ArqueologiaDigital/Custom_TV_Games/README.md

# Custom_TV_Games

Materials for a study group focused on exploring the ideas described in the book "How To Design and Build You Own Custom TV Games" by David L. Heiserman (November, 1978).

* KICAD: Circuits from the book re-drawn on CAD software for experimental PCB manufacturing. These are adapted for being built nowadays (2018).
* LaTeX: A transcription of the book in LaTeX syntax.
