ArqueologiaDigital/Custom_TV_Games/LaTeX/images/fig2-4a.png

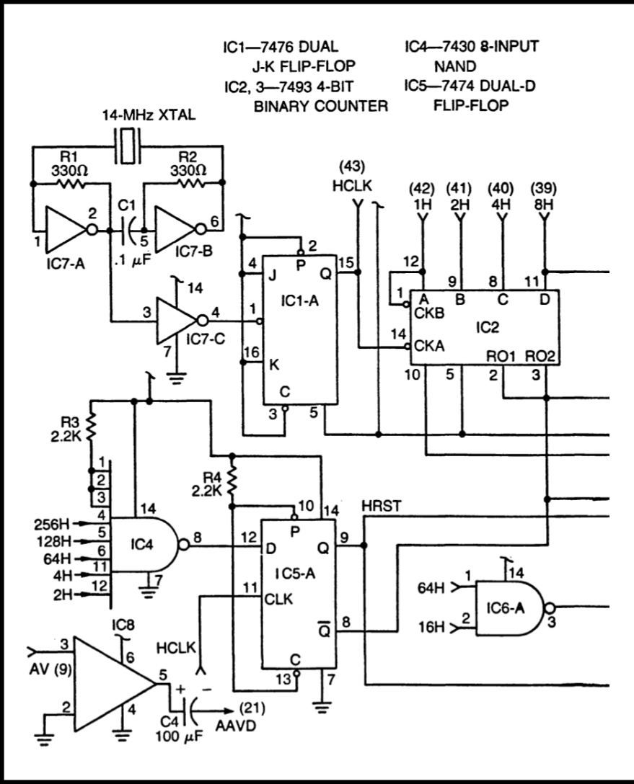
LaTeX/images/fig2-4a.png
