ArqueologiaDigital/Custom_TV_Games/LaTeX/images/fig2-4b.png

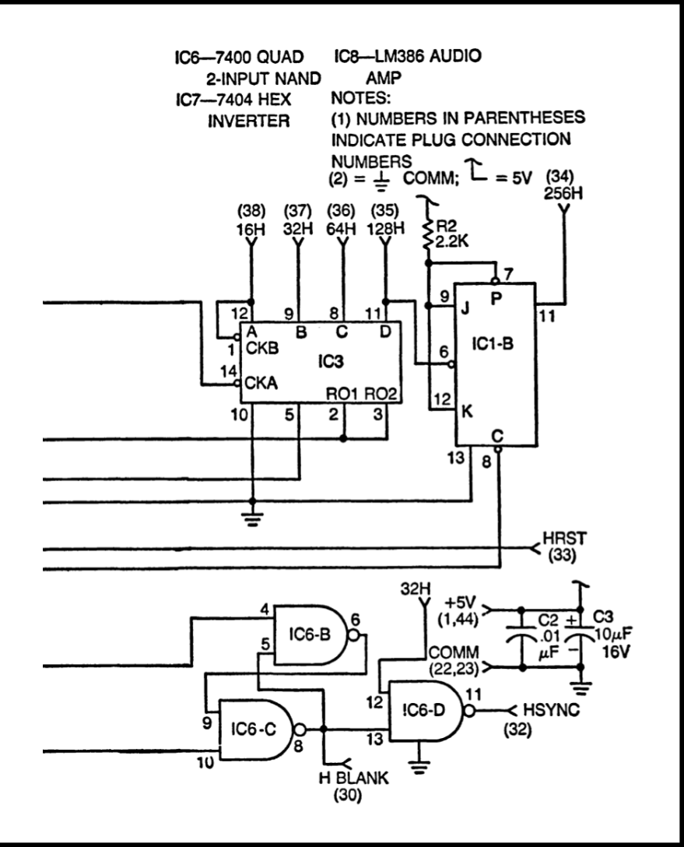
LaTeX/images/fig2-4b.png
