ArqueologiaDigital/Custom_TV_Games/KICAD/sourcebox/sourcebox.pdf

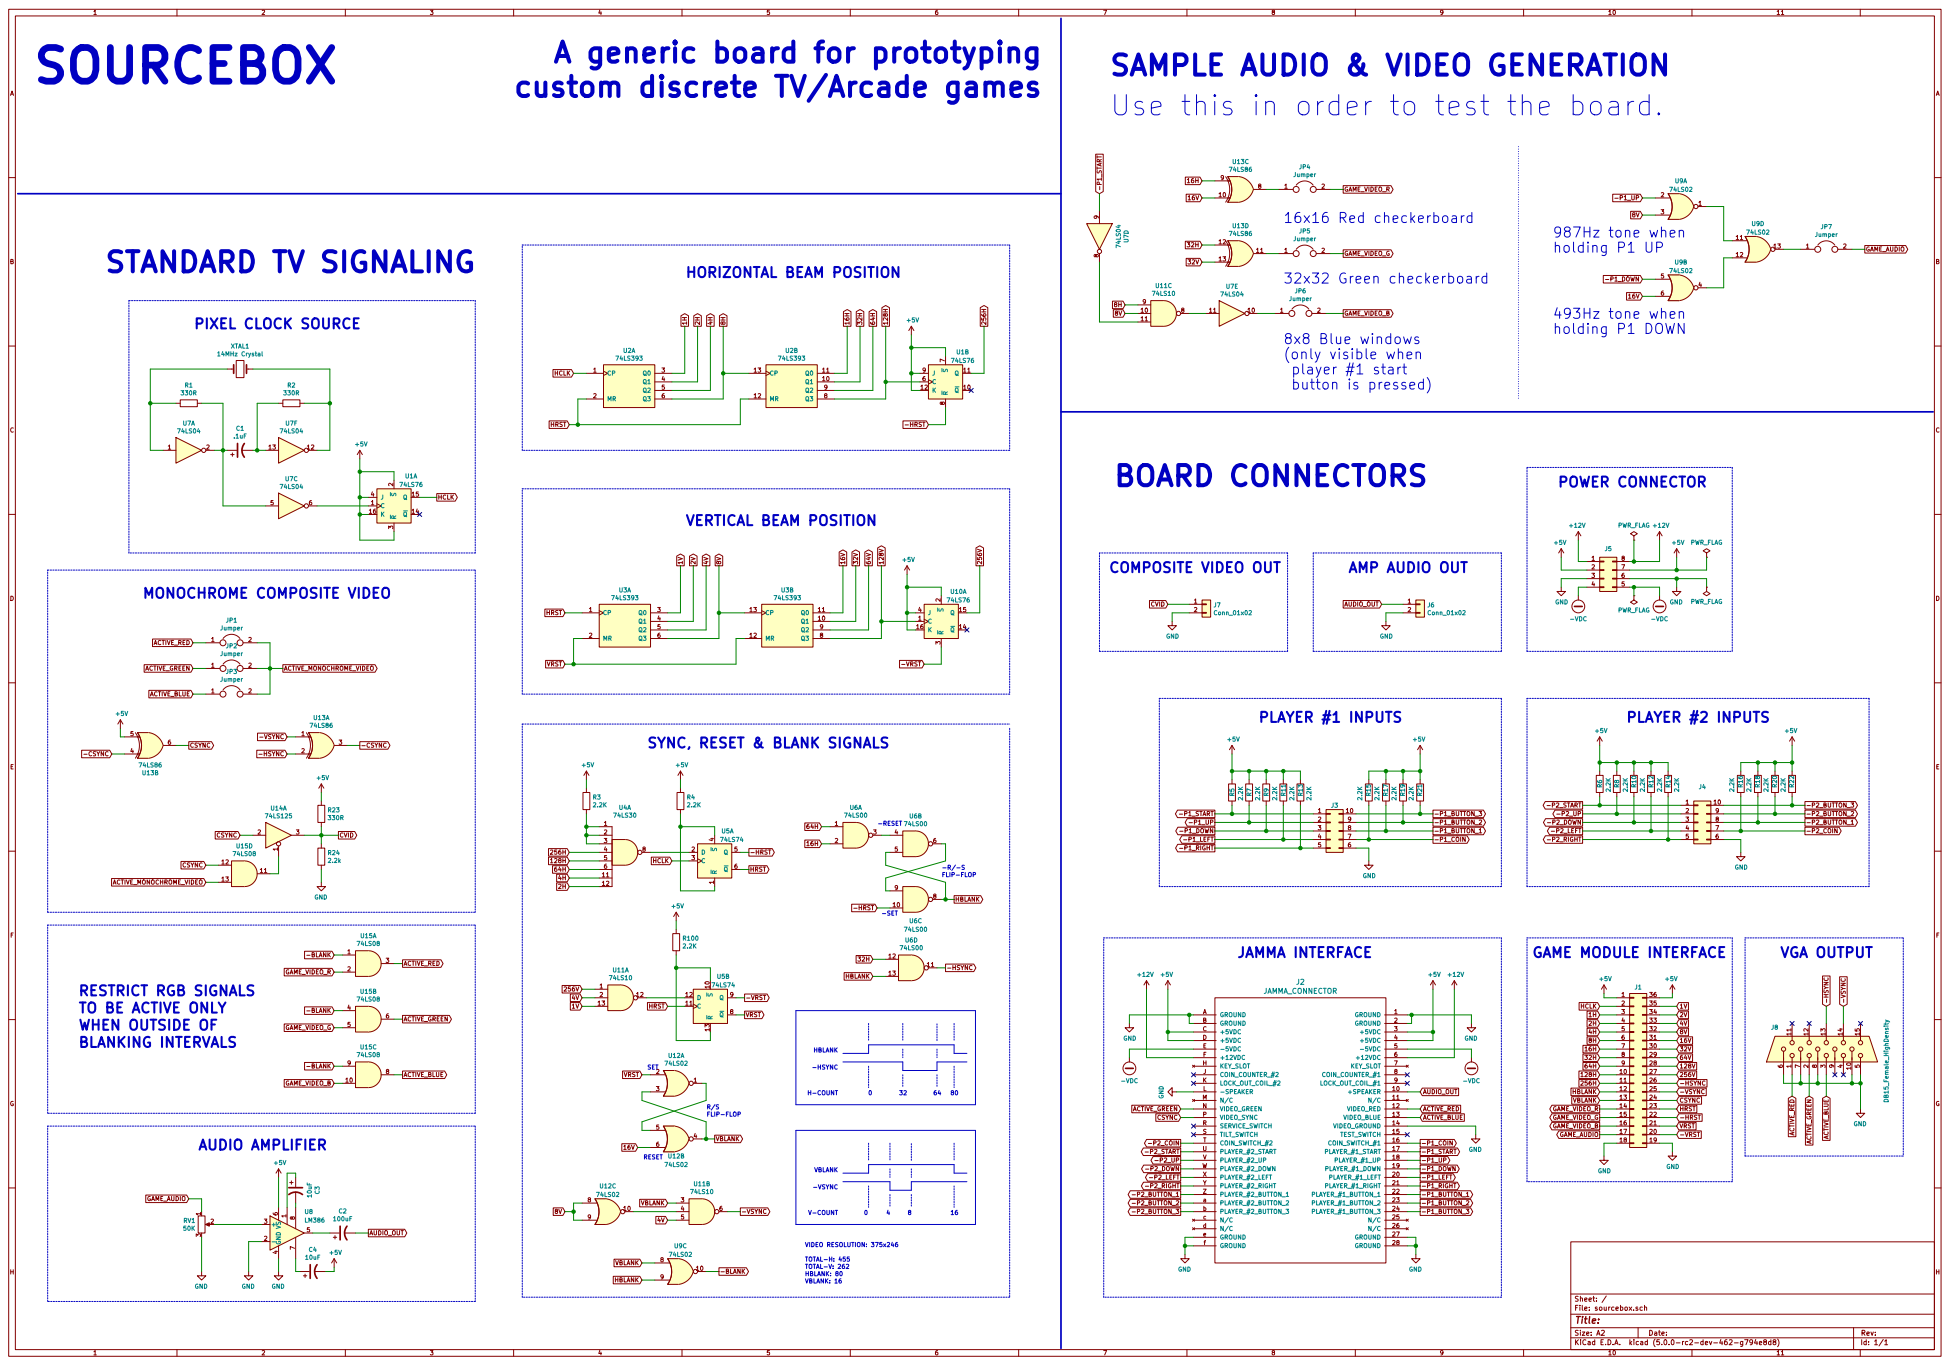
[picture p16: page 1]

SAMPLE AUDIO & VIDEO GENERATION

custom discrete TV/Arcade games

Use this in order to test the board.

HCLK PIXEL CLOCK SOURCE

CVID COMPOSITE VIDEO OUT

ACTIVE_BLUE RESTRICT RGB SIGNALS
TO BE ACTIVE ONLY
WHEN OUTSIDE OF
BLANKING INTERVALS

FLIP-FLOP RESET SET
VRST

Id: 1/1 Title: File: sourcebox.sch Sheet: /
