ArqueologiaDigital/Custom_TV_Games/KICAD/sourcebox/sourcebox.kicad_pcb

## KiCad design schematics/Doorbell.sch


Parts:
ESP32_1: ESP32-WROOM-32
R1: 100Ω
SW1: SW_Push_LED_NO
VCC: 3.3V

Connections:
unnamed: ESP32_1.1 (GND), ESP32_1.15 (GND), ESP32_1.38 (GND), ESP32_1.39 (GND), VCC.2 (-)
unnamed: ESP32_1.2 (VDD), VCC.1 (+)
unnamed: ESP32_1.13 (IO14), SW1.2
unnamed: ESP32_1.16 (IO13), SW1.1
unnamed: ESP32_1.23 (IO15), R1.2
unnamed: ESP32_1.27 (IO16), SW1.4 (A)
unnamed: R1.1, SW1.3 (K)

Notes on the sheet:
ESP32 Doorbell with Slack integration
14 January 2021
