ArqueologiaDigital/Custom_TV_Games/(commit log)

2018-12-23 initial commit (LaTeX + KICAD + README)
    [sourcebox.kicad_pcb, sourcebox.sch]
2018-12-23 remove spurious/extra sourcebox directory
    [sourcebox.kicad_pcb, sourcebox.sch]
2018-12-24 [KICAD] a lot of work on the source box schematics
    [sourcebox.sch]
2018-12-24 [KICAD] SourceBox test-pattern generator and additional tweaks in the design
    [sourcebox.sch]
2018-12-24 [KICAD] Adding audio circuits
    [sourcebox.sch]
2018-12-24 [KICAD] Adding VGA-OUT connector
    [sourcebox.sch]
2018-12-24 [KICAD] draw sync/blank diagrams and annotate flip-flops
    [sourcebox.sch]
2018-12-24 [KICAD] Fix Vsync circuit
    [sourcebox.sch]
